ErhannisAutomated/s3_power_module/(list of files, drawings)

Other design files:
power_module_planes.dsn
