ErhannisAutomated/s3_power_module/power_module.kicad_pcb

## KiCad design power_module.kicad_pcb (2026-06-16)

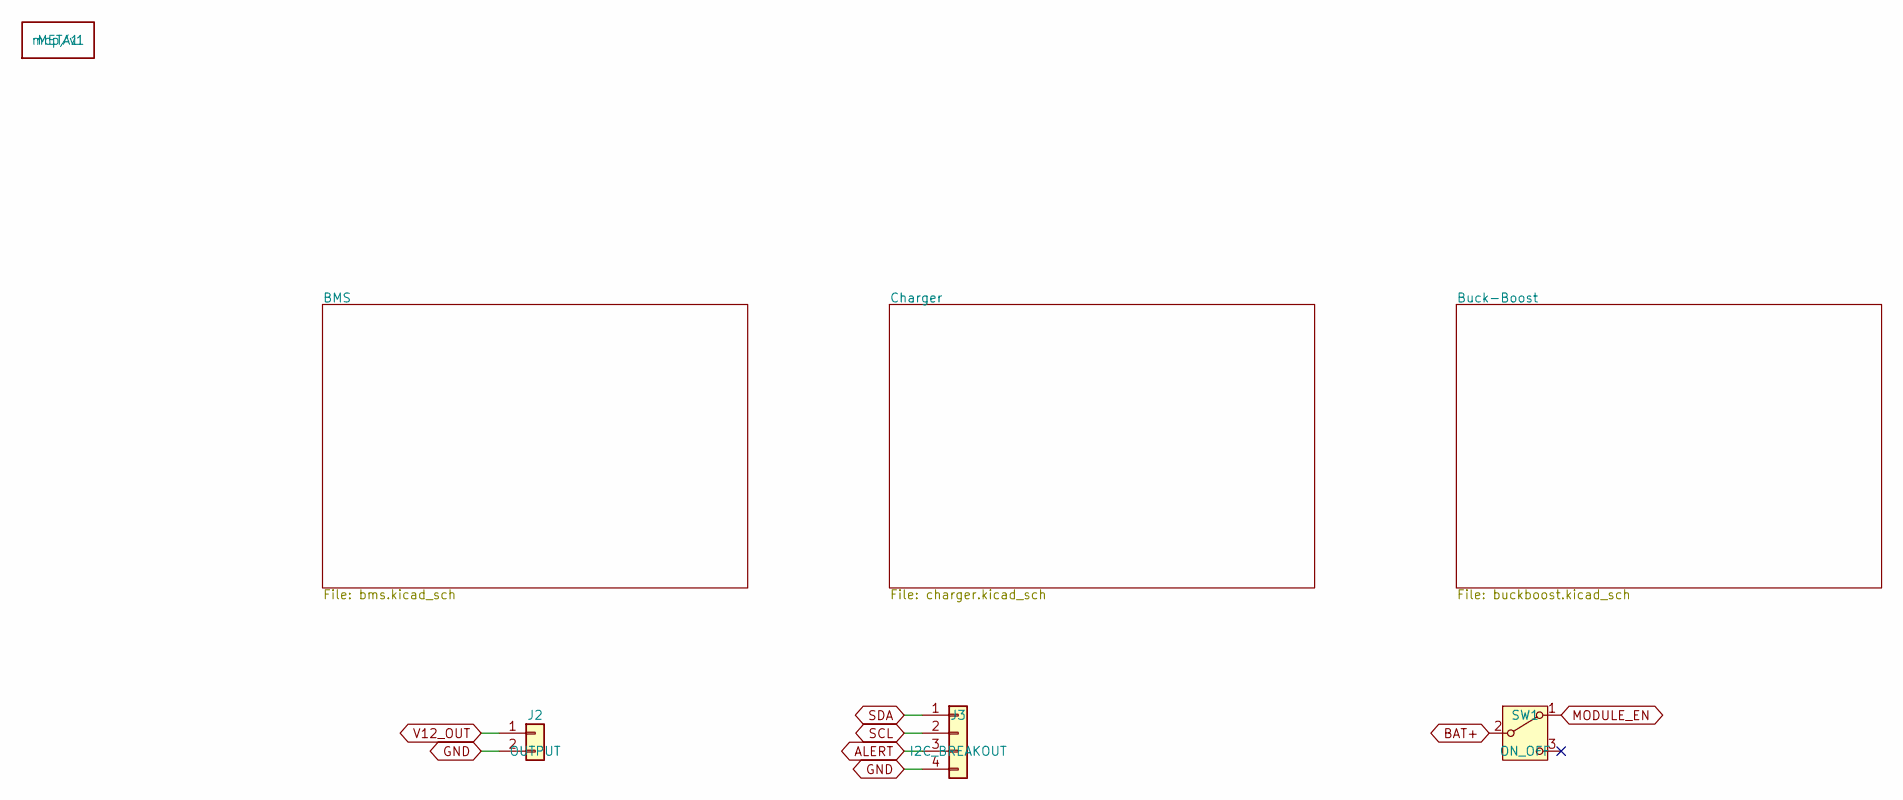
[picture p1: schematic power_module.kicad_sch]

Parts:
J2: OUTPUT; PinHeader_1x02_P2.54mm_Vertical
J3: I2C_BREAKOUT; PinHeader_1x04_P2.54mm_Vertical
META1: mcp/v1
SW1: ON_OFF; SW_SPDT_PCM12

Connections:
ALERT: J3.3; also elsewhere on the board
BAT+: SW1.2 (B); also elsewhere on the board
GND: J2.2, J3.4; also elsewhere on the board
MODULE_EN: SW1.1 (A); also elsewhere on the board
SCL: J3.2; also elsewhere on the board
SDA: J3.1; also elsewhere on the board
V12_OUT: J2.1; also elsewhere on the board

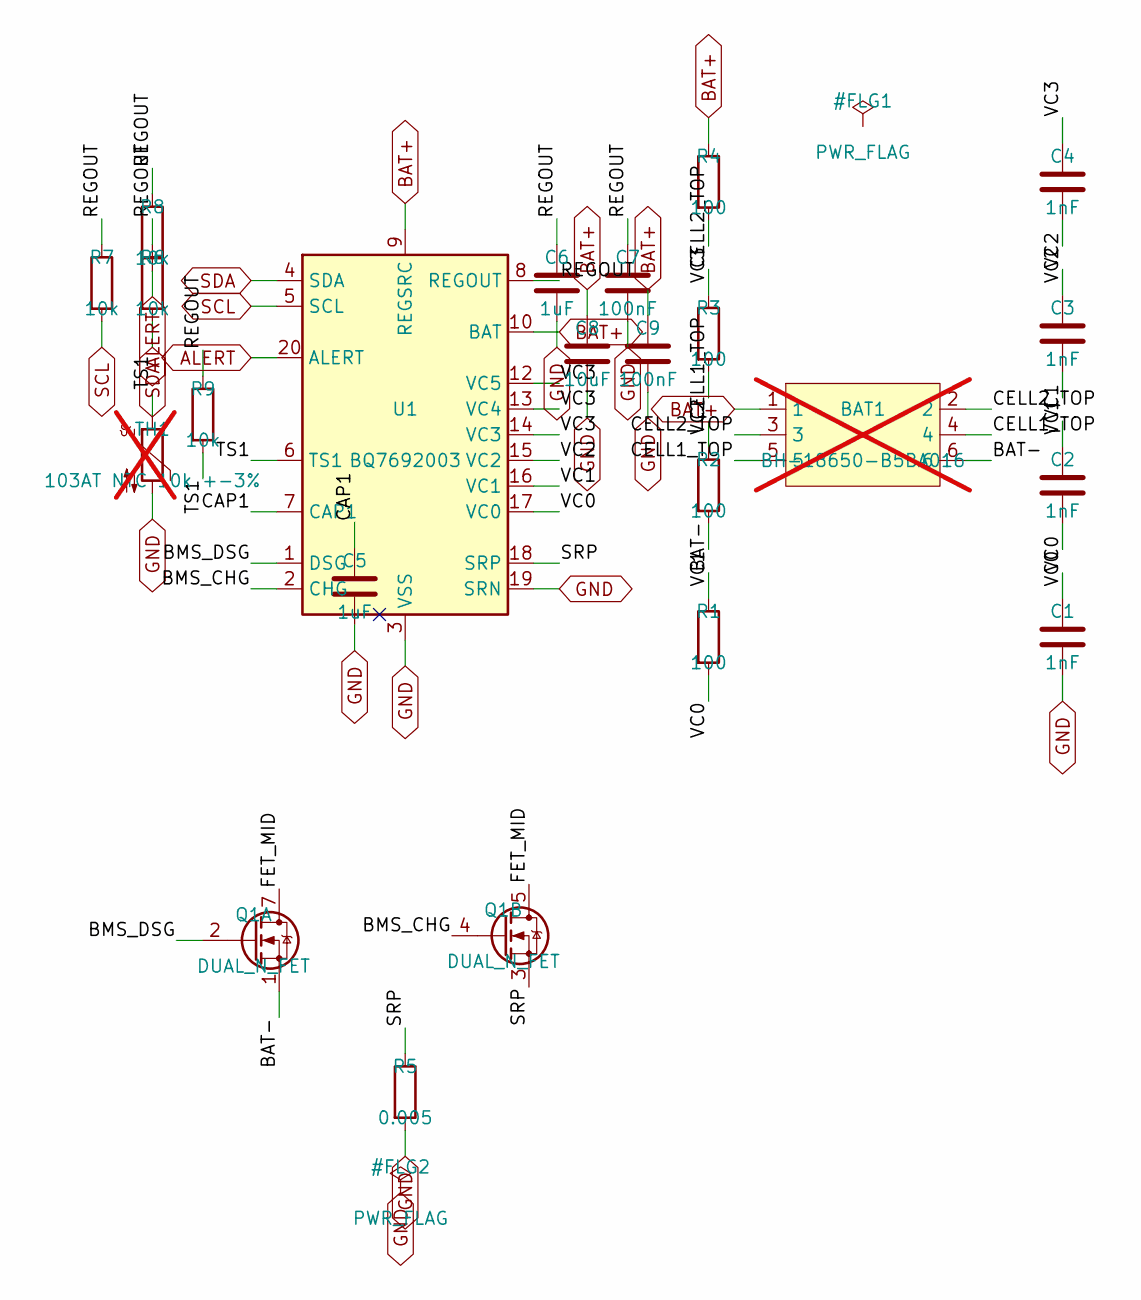
[picture p2: schematic bms.kicad_sch]

Parts:
BAT1: BH-18650-B5BA016; BAT-SMD_BH-18650-B5BA016; LCSC C19184086; not fitted
C1, C2, C3, C4: 1nF; C_0603_1608Metric; LCSC C1588
C5, C6: 1uF; C_0805_2012Metric; LCSC C28323
C7, C9: 100nF; C_0603_1608Metric; LCSC C14663
C8: 10uF; C_0805_2012Metric; LCSC C15850
Q1: DUAL_N_FET; SOIC-8_3.9x4.9mm_P1.27mm; LCSC C353066
R1, R2, R3, R4: 100; R_0603_1608Metric; LCSC C22775
R5: 0.005; R_1206_3216Metric; LCSC C2988648
R6, R7, R8, R9: 10k; R_0603_1608Metric; LCSC C25804
TH1: 103AT NTC 10k +-3%; R_Axial_DIN0204_L3.6mm_D1.6mm_P1.90mm_Vertical; not fitted
U1: BQ7692003; TSSOP-20_4.4x6.5mm_P0.65mm; LCSC C601650

Connections:
ALERT: R8.2, U1.20 (ALERT); also elsewhere on the board
BAT+: BAT1.1, C8.1, C9.1, R4.1, U1.9 (REGSRC), U1.10 (BAT); also elsewhere on the board
BAT-: BAT1.6, Q1.1 (S1), R1.1
BMS_CHG: Q1.4 (G2), U1.2 (CHG)
BMS_DSG: Q1.2 (G1), U1.1 (DSG)
CAP1: C5.1, U1.7 (CAP1)
CELL1_TOP: BAT1.4, BAT1.5, R2.1
CELL2_TOP: BAT1.2, BAT1.3, R3.1
FET_MID: Q1.5 (D2), Q1.6 (D2), Q1.7 (D1), Q1.8 (D1)
GND: C1.2, C5.2, C6.2, C7.2, C8.2, C9.2, R5.2, TH1.2, U1.3 (VSS), U1.19 (SRN); also elsewhere on the board
REGOUT: C6.1, C7.1, R6.1, R7.1, R8.1, R9.1, U1.8 (REGOUT)
SCL: R7.2, U1.5 (SCL); also elsewhere on the board
SDA: R6.2, U1.4 (SDA); also elsewhere on the board
SRP: Q1.3 (S2), R5.1, U1.18 (SRP)
TS1: R9.2, TH1.1, U1.6 (TS1)
VC0: C1.1, C2.2, R1.2, U1.17 (VC0)
VC1: C2.1, C3.2, R2.2, U1.16 (VC1)
VC2: C3.1, C4.2, R3.2, U1.15 (VC2)
VC3: C4.1, R4.2, U1.12 (VC5), U1.13 (VC4), U1.14 (VC3)

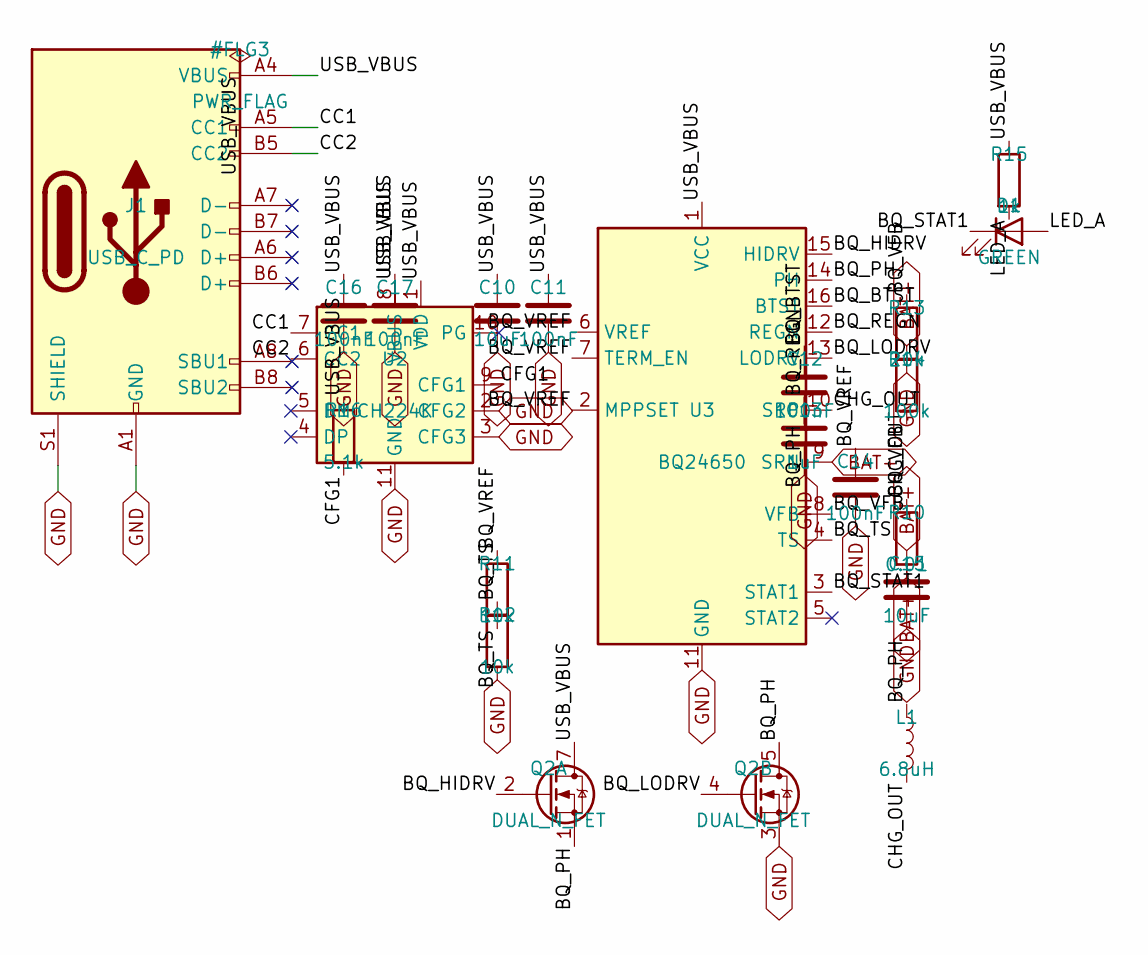
[picture p3: schematic charger.kicad_sch]

Parts:
C10, C15: 10uF; C_0805_2012Metric; LCSC C15850
C11, C12, C14, C16, C17: 100nF; C_0603_1608Metric; LCSC C14663
C13: 1uF; C_0805_2012Metric; LCSC C28323
D1: GREEN; LED_0805_2012Metric; LCSC C2297
J1: USB_C_PD; USB_C_Receptacle_HRO_TYPE-C-31-M-12; LCSC C165948
L1: 6.8uH; IND-SMD_L7.0-W6.6; LCSC C167221
Q2: DUAL_N_FET; SOIC-8_3.9x4.9mm_P1.27mm; LCSC C353066
R10: 0.01; R_1206_3216Metric; LCSC C601097
R11, R12: 10k; R_0603_1608Metric; LCSC C25804
R13: 20k; R_0603_1608Metric; LCSC C4184
R14: 100k; R_0603_1608Metric; LCSC C25803
R15: 1k; R_0603_1608Metric; LCSC C21190
R16: 5.1k; R_0603_1608Metric; LCSC C23186
U2: CH224K; MSOP-10_3x3mm_P0.5mm; LCSC C970725
U3: BQ24650; QFN-16-1EP_3x3mm_P0.5mm_EP1.7x1.7mm; LCSC C53712

Connections:
BAT+: C15.1, R10.2, R14.1, U3.9 (SRN); also elsewhere on the board
BQ_BTST: C12.1, U3.16 (BTST)
BQ_HIDRV: Q2.2 (G1), U3.15 (HIDRV)
BQ_LODRV: Q2.4 (G2), U3.13 (LODRV)
BQ_PH: C12.2, L1.1, Q2.1 (S1), Q2.5 (D2), Q2.6 (D2), U3.14 (PH)
BQ_REGN: C13.1, U3.12 (REGN)
BQ_STAT1: D1.1 (K), U3.3 (STAT1)
BQ_TS: R11.2, R12.1, U3.4 (TS)
BQ_VFB: R13.1, R14.2, U3.8 (VFB)
BQ_VREF: C14.1, R11.1, U3.2 (MPPSET), U3.6 (VREF), U3.7 (TERM_EN)
CC1: J1.A5 (CC1), U2.7 (CC1)
CC2: J1.A8 (SBU1), J1.B5 (CC2), U2.6 (CC2)
CFG1: R16.2, U2.9 (CFG1)
CHG_OUT: L1.2, R10.1, U3.10 (SRP)
GND: C10.2, C11.2, C13.2, C14.2, C15.2, C16.2, C17.2, J1.A1 (GND), J1.A12 (GND), J1.B1 (GND), J1.B12 (GND), J1.S1 (SHIELD), Q2.3 (S2), R12.2, R13.2, U2.2 (CFG2), U2.3 (CFG3), U2.11 (GND), U3.11 (GND), U3.17 (GND); also elsewhere on the board
LED_A: D1.2 (A), R15.2
USB_VBUS: C10.1, C11.1, C16.1, C17.1, J1.A4 (VBUS), J1.A9 (VBUS), J1.B4 (VBUS), J1.B9 (VBUS), Q2.7 (D1), Q2.8 (D1), R15.1, R16.1, U2.1 (VDD), U2.8 (VBUS), U3.1 (VCC)

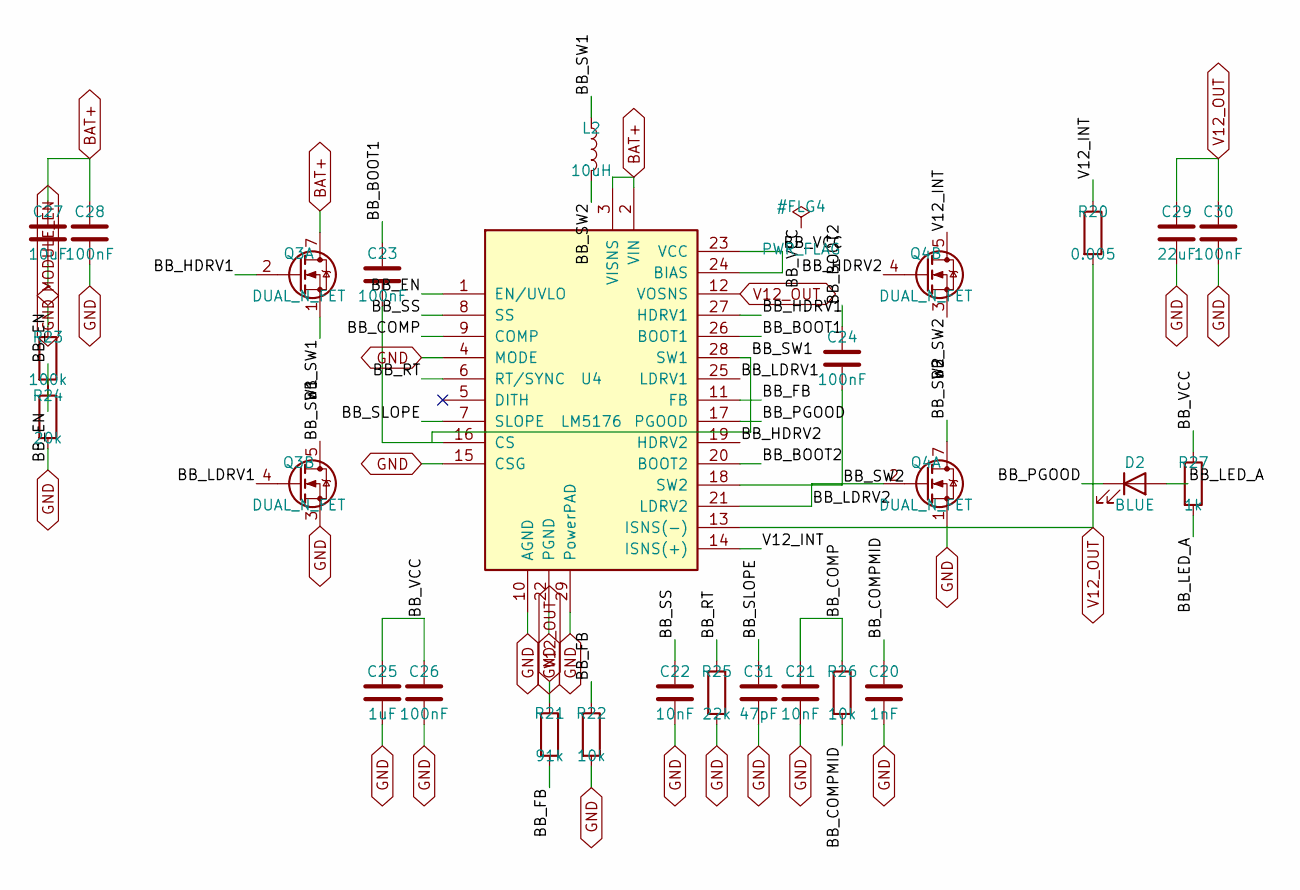
[picture p4: schematic buckboost.kicad_sch]

Parts:
C20: 1nF; C_0603_1608Metric; LCSC C1588
C21, C22: 10nF; C_0603_1608Metric; LCSC C57112
C23, C24, C26, C28, C30: 100nF; C_0603_1608Metric; LCSC C14663
C25: 1uF; C_0805_2012Metric; LCSC C28323
C27: 10uF; C_0805_2012Metric; LCSC C15850
C29: 22uF; C_1206_3216Metric; LCSC C12891
C31: 47pF; C_0603_1608Metric; LCSC C1671
D2: BLUE; LED_0805_2012Metric; LCSC C84259
L2: 10uH; IND-SMD_L7.1-W6.6; LCSC C41407100
Q3, Q4: DUAL_N_FET; SOIC-8_3.9x4.9mm_P1.27mm; LCSC C353066
R20: 0.005; R_1206_3216Metric; LCSC C2988648
R21: 91k; R_0603_1608Metric; LCSC C2907077
R22, R26: 10k; R_0603_1608Metric; LCSC C25804
R23: 100k; R_0603_1608Metric; LCSC C25803
R24: 20k; R_0603_1608Metric; LCSC C4184
R25: 22k; R_0603_1608Metric; LCSC C31850
R27: 1k; R_0603_1608Metric; LCSC C21190
U4: LM5176; HTSSOP-28-1EP_4.4x9.7mm_P0.65mm_EP2.85x5.4mm_ThermalVias; LCSC C442493

Connections:
BAT+: C27.1, C28.1, Q3.7 (D1), Q3.8 (D1), U4.2 (VIN), U4.3 (VISNS); also elsewhere on the board
BB_BOOT1: C23.1, U4.26 (BOOT1)
BB_BOOT2: C24.1, U4.20 (BOOT2)
BB_COMP: C21.1, R26.1, U4.9 (COMP)
BB_COMPMID: C20.1, R26.2
BB_EN: R23.2, R24.1, U4.1 (EN/UVLO)
BB_FB: R21.2, R22.1, U4.11 (FB)
BB_HDRV1: Q3.2 (G1), U4.27 (HDRV1)
BB_HDRV2: Q4.4 (G2), U4.19 (HDRV2)
BB_LDRV1: Q3.4 (G2), U4.25 (LDRV1)
BB_LDRV2: Q4.2 (G1), U4.21 (LDRV2)
BB_LED_A: D2.2 (A), R27.2
BB_PGOOD: D2.1 (K), U4.17 (PGOOD)
BB_RT: R25.1, U4.6 (RT/SYNC)
BB_SLOPE: C31.1, U4.7 (SLOPE)
BB_SS: C22.1, U4.8 (SS)
BB_SW2: C24.2, L2.2, Q4.3 (S2), Q4.7 (D1), Q4.8 (D1), U4.18 (SW2)
BB_VCC: C25.1, C26.1, R27.1, U4.23 (VCC), U4.24 (BIAS)
GND: C20.2, C21.2, C22.2, C25.2, C26.2, C27.2, C28.2, C29.2, C30.2, C31.2, Q3.3 (S2), Q4.1 (S1), R22.2, R24.2, R25.2, U4.4 (MODE), U4.10 (AGND), U4.15 (CSG), U4.22 (PGND), U4.29 (PowerPAD); also elsewhere on the board
MODULE_EN: R23.1; also elsewhere on the board
V12_INT: Q4.5 (D2), Q4.6 (D2), R20.1, U4.14 (ISNS(+))
V12_OUT: C29.1, C30.1, R20.2, R21.1, U4.12 (VOSNS), U4.13 (ISNS(-)); also elsewhere on the board

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
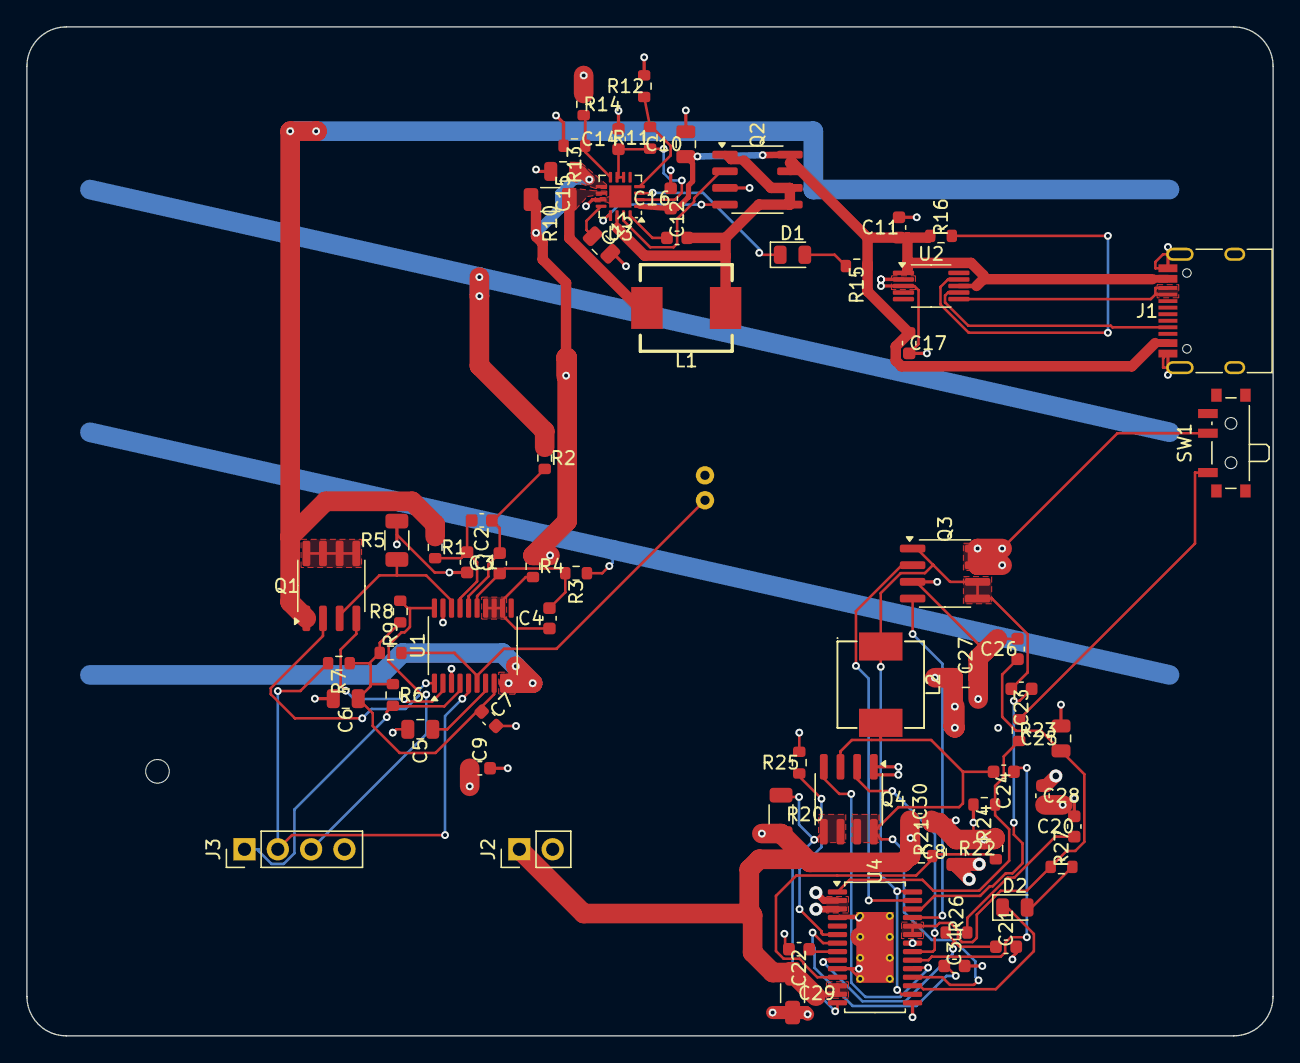
[picture p5: board power_module.kicad_pcb from above]

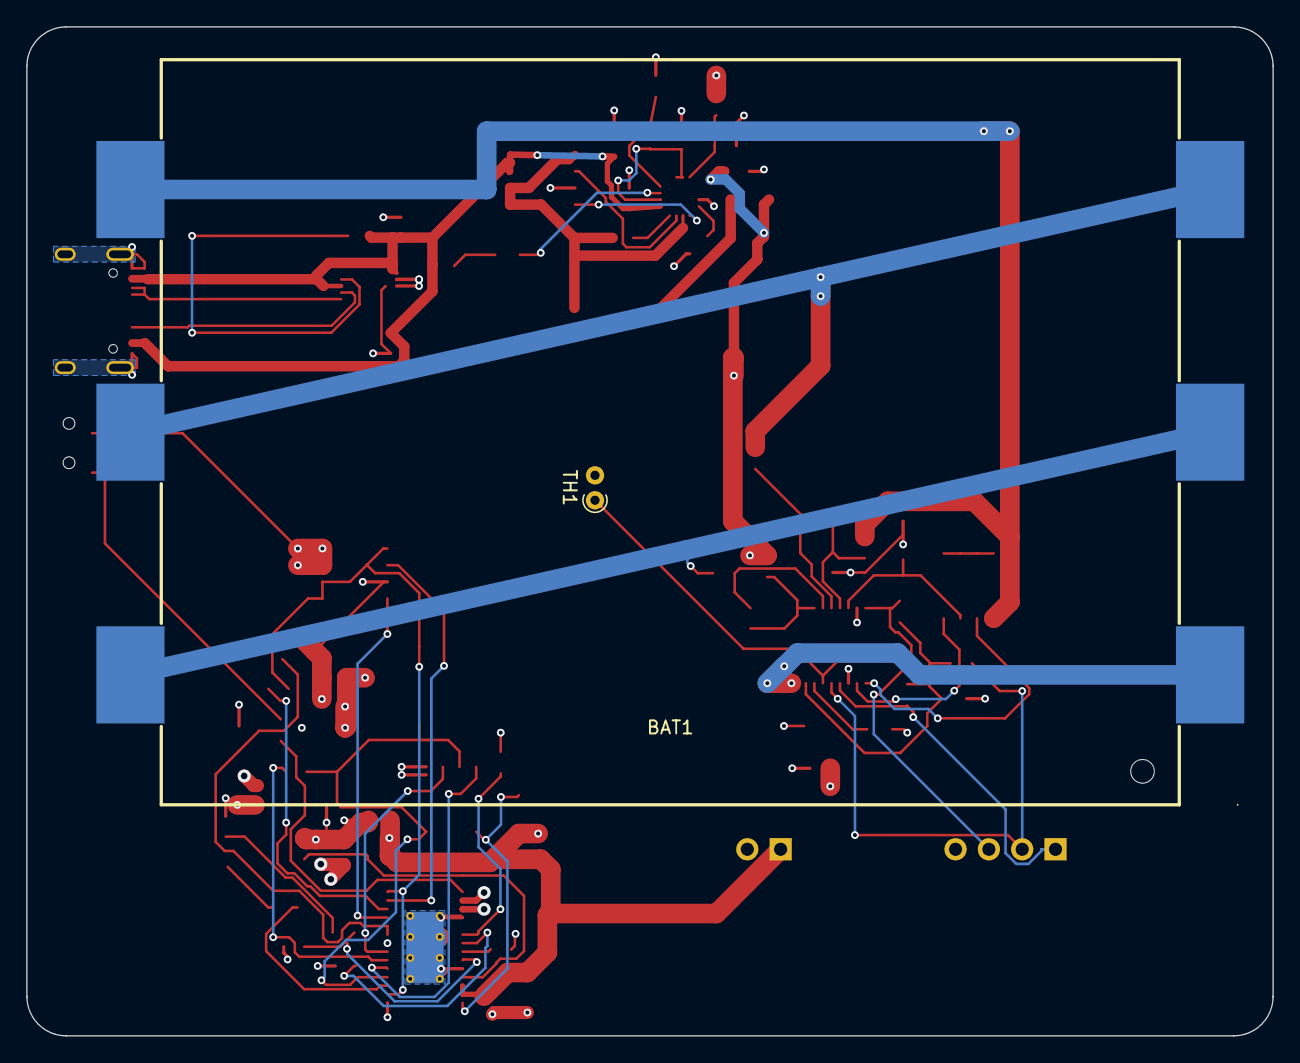
[picture p6: board power_module.kicad_pcb from below]

Board: 4 copper layers, 95.0 x 76.9 mm, 71 parts (2 on the bottom side), 55 nets.
