ErhannisAutomated/s3_power_module/(commit log)

2026-05-08 init: project spec for 3S 18650 12V power module
    Captures the original design prompt + later clarifications (cell holder
    choice C19184086, open decisions still to confirm). The schematic and
    PCB will be added in subsequent commits as the design progresses.
2026-05-08 spec: lock topology + switch placement decisions
    Walked back an earlier (mistaken) suggestion to put a high-side MOSFET
    on the 12 V output for user on/off. The user pointed out their
    original design had the protection FETs in series with battery
    negative — that's the canonical BMS architecture and the right
    placement. Reusing those CHG/DSG protection FETs for the user
    on/off switch (via the BMS shutdown pin) avoids a redundant output
    FET and drops quiescent current in OFF state to BMS sleep current.
    Locked decisions:
    - 4-switch buck-boost regulator for the 12 V output (handles full
    9-12.6 V battery range)
    - Single pair of CHG/DSG N-channel FETs in series with battery
    negativ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
2026-05-08 spec: lock major IC picks (CH224K, BQ25700A, BQ7692003, LM5176, dual N-FET C353066)
    Verified each in JLC's catalog with stock levels. Picks favour high
    stock + reasonable price + JLC SMT-friendly packages. All Extended
    parts ($3 setup fee per unique part), so 5 unique ICs ≈ $15 setup;
    acceptable for a one-off prototype.
    Topology summary:
    USB-C → CH224K (PD sink, requests 15-20 V) → BQ25700A charger →
    3S 18650 in C19184086 holder → BQ7692003 BMS with CHG/DSG FETs at
    battery negative → LM5176 4-switch buck-boost → 12 V / 4 A out
    C353066 dual-N-MOSFET (SOP-8, 30 V, 8 A, 26 mΩ, 1.5 V Vgs(th))
    covers both BMS protection FETs (2 needed) and LM5176 power FETs (4
    needed). R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
2026-05-08 spec: switch charger from BQ25700A to BQ24650RVAR
    BQ25700A had SMBus telemetry but is QFN-32 with no stock KiCAD symbol —
    ~hours of custom-symbol work to use it.
    BQ24650RVAR is simpler (VQFN-16), better stock (5,453 vs 3,224 units),
    covers the same use case (5-28 V input handles USB-C PD's 20 V; NMOS
    sync-buck supports up to 10 A so 4 A continuous is comfortable), and
    has a stock KiCAD symbol in Battery_Management.
    We don't lose I²C: the BQ76920 BMS already provides cell-level telemetry
    on I²C, which was the user's actual ask. Charger-level SMBus would
    have been redundant.
    All four major ICs (CH224K, BQ24650, BQ76920, LM5176) now have stock
    symbols — schematic can be built without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
2026-05-08 init: KiCAD project files (empty schematic + PCB)
    Created via mcp__kicad__create_project; subsequent commits will fill
    in the schematic and PCB.
    [power_module.kicad_pcb, power_module.kicad_sch]
2026-05-08 schematic: place BMS subcircuit components
    25 components placed (no wires yet) in the BMS subcircuit:
    U1 BQ7692003 BMS chip (TSSOP-20)
    BT1-3 three 18650 cells stacked at x=175
    R1-4 cell-tap resistors (100 Ω) for VC0..VC3
    C1-4 cell-tap RC-filter caps (1 nF)
    Q1 dual N-channel MOSFET (FDS9926A symbol; will swap value
    to C353066 in the LCSC pass) for CHG + DSG protection
    R5 0.005 Ω current-sense shunt
    C5 1 µF cap on CAP1 (cell-balance bootstrap)
    C6/C7 REGOUT bypass (1 µF + 100 nF)
    C8/C9 BAT decoupling (10 µF + 100 nF)
    R6-8 I²C SDA/SCL + ALERT pull-ups (10 kΩ)
    R9 NTC bias (10 kΩ)
    TH1 10 kΩ NTC thermistor on TS1
    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
    [power_module.kicad_sch]
2026-05-08 notes: session resume notes for next session
    Captures:
    - State at end of 2026-05-08 (BMS placed, no wires)
    - Ordered next-step list (wire BMS, then charger, then buck-boost,
    then integrate, then footprints/LCSC, then PCB)
    - BQ76920PW pin reference (so we don't have to re-extract from
    the .kicad_sym file)
    - Wiring intent for the BMS subcircuit
    - Q1 → C353066 substitution note (the FDS9926A symbol stands in
    for the part we'll specify in LCSC)
    - Cross-references to MCP-server open threads + memory files
    Intended to survive Claude Code context compaction by living in
    the project repo on disk.
2026-05-08 notes: record 4-layer stackup + ampacity-sized traces preferences for layout
    Both flagged by user this morning before resuming BMS wiring. Layer
    count and per-class trace widths haven't been tested through the MCP
    server yet; watch for issues during the eventual layout pass.
2026-05-08 schematic: wire BMS subcircuit (cell stack, taps, FETs, signals)
    All BMS-side connectivity in place via local net labels:
    - Cell stack: BAT+ / CELL2_TOP / CELL1_TOP / BAT-
    - Cell taps: VC0..VC3 with R1-R4 + RC caps C1-C4 (3S jumpers tie
    VC4=VC5=VC3 at the BMS pins, post-filter resistor)
    - Protection FETs Q1: dual N-FET in back-to-back (drains tied =
    FET_MID, sources to BAT- and SRP, gates to BMS_DSG/BMS_CHG).
    Added Q1 unit 2 (FDS9926A symbol is multi-unit; only unit 1 was
    placed previously).
    - Sense resistor R5: SRP at top, GND at bottom = U1.SRN = U1.VSS.
    - Support passives: REGOUT (C6/C7), BAT/REGSRC (C8/C9 on BAT+),
    CAP1 (C5).
    - Signals: SDA/SCL/ALERT pull-ups to REGOUT (R6/R7/R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
    [power_module.kicad_sch]
2026-05-08 schematic: add charger subcircuit (USB-C PD + BQ24650 sync buck)
    22 components placed and wired:
    - USB-C PowerOnly_24P receptacle (J1) → CH224K (U2) PD sink controller
    (configured for 20V request: CFG2/CFG3 to GND, CFG1 pulled to VDD via R16)
    - CH224K VBUS → BQ24650 (U3) input
    - BQ24650 sync buck: HIDRV/LODRV → Q2 dual N-FET (FDS9926A symbol;
    C353066 substitute at LCSC step), drains tied at PH/SW node, BTST
    bootstrap cap C12, REGN gate-drive cap C13, VREF bypass C14.
    - Inductor L1 (6.8 µH) between PH and inductor-output node.
    - Charger sense resistor R10 (10 mΩ) between SRP and BAT+ output;
    C15 output cap.
    - VFB divider R14/R13 (100k / 20k) sets 12.6V regulation
    (VFB = 2.1V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
    [power_module.kicad_sch]
2026-05-09 schematic: add 4-switch buck-boost output stage (LM5176)
    LM5176PWP HTSSOP-28 controller drives 2x dual N-FET pairs (Q3 input,
    Q4 output) through inductor L2 (10 µH). Topology:
    BAT+ → Q3a (HS_IN) → SW1 → L2 → SW2 → Q4b (HS_OUT) → V12_OUT
    ↓ ↓
    Q3b (LS_IN)→GND Q4a (LS_OUT)→GND
    + ISNS shunt R20 (5 mΩ) between Q4b drain and V12_OUT load.
    Regulation: VFB divider R21=90k / R22=10k → 12 V at FB=1.207 V.
    Soft-start C22=10 nF, RT/SYNC R25=22k (~440 kHz), Type II compensation
    C20/R26/C21 on COMP, slope cap C31=47 pF. Mode pin tied to GND for
    auto-PFM at light load.
    Power: input bulk + HF caps on BAT+ side (C27/C28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
    [power_module.kicad_sch]
2026-05-09 schematic: convert flat design into hierarchical sheets
    Split the single power_module.kicad_sch into a thin top-level that
    holds three sheet blocks (BMS, Charger, Buck-Boost) referencing
    sibling files bms.kicad_sch / charger.kicad_sch / buckboost.kicad_sch.
    Partition (via /tmp/claude/partition_sheets.py):
    - Components grouped by reference designator into BMS_REFS /
    CHARGER_REFS / BUCKBOOST_REFS buckets (28 / 23 / 28 symbols).
    - Wires kept by BFS from each kept symbol's pin world coords —
    grows the keep-set until no new wires can be reached.
    - Labels / junctions / no_connects kept when their position is
    on a kept-component pin OR a kept-wire endpoint.
    - Each child gets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
    [bms.kicad_sch, buckboost.kicad_sch, charger.kicad_sch, power_module.kicad_sch]
2026-05-09 schematic: integrate subcircuits — output, I²C, user switch
    Top-level power_module.kicad_sch gains the user-facing components:
    J2 Conn_01x02 output header : V12_OUT, GND
    J3 Conn_01x04 I²C breakout : SDA, SCL, ALERT, GND
    SW1 SW_SPDT user on/off switch : MODULE_EN ↔ BAT+ (pin 3 NC)
    For these to span sheets, V12_OUT (Buck-Boost) and SDA/SCL/ALERT (BMS)
    were promoted from local labels to global_label inside their child
    sheets (one Python pass over each .kicad_sch). KiCad joins
    global_labels by name across all sheets without sheet pins.
    User switch behaviour: SW1 routes BAT+ through to a new MODULE_EN
    global net. Inside buckboost.kicad_sch, R23.pin1 (t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
    [bms.kicad_sch, buckboost.kicad_sch, power_module.kicad_sch]
2026-05-09 schematic: re-orient existing labels to match their pin's outward angle
    One-shot pass over all four .kicad_sch files: for each label, find the
    nearest pin (directly coincident or via a 1-3 hop wire-graph walk
    from the label's anchor) and set the label's orientation to that
    pin's outward angle. Labels not near a pin (mid-wire stubs, dangling
    markers) are left alone.
    power_module: 7 of 8 labels updated
    bms: 61 of 71 labels updated
    charger: 52 of 69 labels updated
    buckboost: 60 of 74 labels updated
    The remaining ~15-20% of labels are either at orientations that were
    already non-zero (caller set explicitly) or at coordinates with no
    pin reachable within the search depth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
    [bms.kicad_sch, buckboost.kicad_sch, charger.kicad_sch, power_module.kicad_sch]
2026-05-09 schematic: repair child-sheet (instances …) paths after partition
    When the flat schematic was split into hierarchical sheets, every
    component carried its (instances (project … (path …))) block from the
    flat design — single-segment path /<flat_root_uuid> — into its new
    child .kicad_sch. KiCad's per-project annotation lookup expects the
    hierarchical path /<top_root_uuid>/<sheet_block_uuid>, so all
    components on child sheets rendered as Q?, R?, etc.
    Per-sheet repair (one-shot, /tmp/claude/repair_instance_paths.py):
    bms.kicad_sch: 27 paths updated
    charger.kicad_sch: 23 paths updated
    buckboost.kicad_sch: 28 paths updated
    Top-level path is computed from the parent fi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
    [bms.kicad_sch, buckboost.kicad_sch, charger.kicad_sch]
2026-05-09 notes: end-of-2026-05-09 session resume notes
    Schematic is complete and split into hierarchical sheets (top-level
    + bms/charger/buckboost children). Cross-sheet nets use global_label.
    Top-level ERC: 0 errors, 1 footprint warning.
    Today's session focused on MCP server improvements (autoplacer,
    sheets, renderer, label orientation, autorouter rule 6, orphan-chain
    fix, cache invalidation). See KiCAD-MCP-Server CHANGELOG for the
    full list.
    Tomorrow's natural starting points are documented in NOTES:
    1. Fix PinLocator multi-unit lookup so the autoplacer's rewire
    can use the autorouter again (instead of label-stubs).
    2. Tune the autoplacer force constants — current placements are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
2026-05-13 schematic: parts pass + cell-holder and USB-C symbol swaps
    - Apply Footprint + LCSC + Description to all 67 non-cell components
    across bms / charger / buckboost (JLCPCB-friendly BOM).
    - Add project-local power_module_lib (symbols + footprints fetched via
    easyeda2kicad for BH-18650-B5BA016 holder and the two custom-package
    inductors).
    - bms: replace BT1-3 (3x Battery_Cell) with single 6-pin BAT1 holder
    (BH-18650-B5BA016, C19184086). Pin mapping respects all-cells-same-
    direction; CELL1_TOP/CELL2_TOP taps repeat on inner pins.
    - charger: swap J1 from USB_C_Receptacle_PowerOnly_24P to
    USB_C_Receptacle_USB2.0_16P (matches HRO TYPE-C-31-M-12 16P
    footprint). NC the 6 unused USB 2.0 d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
    [bms.kicad_sch, buckboost.kicad_sch, charger.kicad_sch]
2026-05-13 pcb: 4-layer stackup, netclasses, partial sync checkpoint
    - Stackup expanded to 4 copper layers (F.Cu/In1.Cu/In2.Cu/B.Cu).
    Plan: In1.Cu = GND pour, In2.Cu = PWR pour.
    - Add POWER_4A (1.5 mm / 0.25 mm clearance, 1.0 mm via) and POWER_2A
    (0.8 mm / 0.2 mm clearance, 0.7 mm via) netclasses in
    power_module.kicad_pro net_settings, with patterns assigning BAT+,
    BAT-, V12_OUT to POWER_4A and USB_VBUS, CHG_OUT, BQ_PH to POWER_2A.
    Done via direct .kicad_pro edit because the MCP add_net_class and
    create_netclass tools are both broken.
    - First sync_schematic_to_board imported only the 3 top-level
    footprints (J2/J3/SW1); a server-side bug skipped the 67
    child-sheet components. Patched in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
    [power_module.kicad_pcb, power_module.kicad_sch]
2026-05-13 pcb: sync 71 footprints from schematic (full hierarchical import)
    After the MCP-server restart picked up the hierarchical-sync fix,
    re-syncing imported all 71 footprints (J2/J3/SW1 from the parent
    sheet plus the 67 child-sheet components plus BAT1 and J1, then U4
    manually after fixing its missing-footprint reference to the
    EP2.85x5.4mm_ThermalVias HTSSOP-28 variant). 256 pads have nets
    assigned.
    Footprints are sitting in an off-board grid above y=0; placement
    into the board area happens in the next step (#89 layout pass).
    Also: add .gitignore for *_erc.json artifacts.
    [buckboost.kicad_sch, power_module.kicad_pcb]
2026-05-13 pcb: first-pass placement for all 71 footprints
    Layout floorplan: 95x110 mm rounded rectangle. Cell holder (BAT1)
    across the top half centered at (47.5, 23). Bottom half partitioned
    into three column strips:
    - x = 0-30: BMS (U1, R1-9, C1-9, Q1, R5, TH1).
    - x = 30-60: charger (J1 region, U2, U3, Q2, L1, R10-16, D1, C10-17).
    - x = 60-95: buck-boost (U4, Q3-Q4, L2, D2, R20-27, C20-31).
    Edge connectors on the south edge: J3 (I2C 4-pin), J2 (12V output
    2-pin), SW1 (slide). USB-C J1 on the east edge.
    This is intentionally rough — autorouting and DRC will surface
    real overlaps and force iteration.
    [power_module.kicad_pcb]
2026-05-13 pcb: persist all 71 placement moves via direct file rewrite
    Workaround for the MCP server bug recorded in mcp_server_issues.md
    (commit b8183d8 in KiCAD-MCP-Server develop): move_component
    silently operated on a different in-memory BOARD than save_project
    wrote, so the first save in this layout pass landed the auto-import
    grid coords instead of the placement.
    Recovered the intended positions from get_component_list (which
    also reads the orphaned BOARD, hence consistent with the moves) and
    rewrote each footprint's (at X Y rot) line directly. Script kept
    at /tmp/claude/apply_positions.py. An MCP-server restart is needed
    before further PCB writes to pick up the fix and reset the diverged
    in-m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
    [power_module.kicad_pcb]
2026-05-13 pcb: rewrite (at) positions with corrected helper script
    apply_positions.py had an off-by-N bug: it advanced its byte cursor
    using the *post-substitution* block length rather than the original
    slice end, so any (at X Y rot) replacement that wrote fewer bytes
    than the source line left the cursor lagging. The next iteration
    then re-emitted the tail bytes of the previous footprint, injecting
    stray top-level ')' characters into the file (which manifested as
    pcbnew.LoadBoard returning only one footprint).
    Fix: track original_len separately from the in-place modified block
    length. Helper script committed at apply_positions.py for future
    recovery.
    [power_module.kicad_pcb]
2026-05-13 pcb: add GND (In1.Cu, B.Cu) and BAT+ (In2.Cu) copper pours
    4-layer stackup is now:
    L1 F.Cu — signal routing
    L2 In1.Cu — GND fill
    L3 In2.Cu — BAT+ fill (highest-current rail)
    L4 B.Cu — GND fill + signal routing
    [power_module.kicad_pcb]
2026-05-13 pcb: first-pass autoroute via Freerouting (8 passes, 64% routed)
    Imported 412 tracks + 74 vias. 184 nets in, 66 still unrouted after
    8 passes and 4 minor violations. Placement is too tight for a
    clean route — R/C cell-tap row at y=47-51 has courtyards overlapping
    and is the most likely contributor to the unrouted count. Saving as
    a checkpoint before iterating placement.
    Note: autoroute MCP wrapper has a 30s TS-side timeout but the
    underlying call needs minutes (run took ~8 minutes for 8 passes).
    Ran freerouting directly via Bash as a workaround.
    [power_module.dsn, power_module.kicad_pcb]
2026-05-13 pcb: iterate 1 — clean tracks, drop B.Cu pour, spread tap-row + R/Cs
    Iteration to reduce the unrouted count from freerouting v1 (66/184).
    Changes this pass:
    - Stripped 412 tracks + 74 vias from previous SES import for a
    clean re-route from the DSN.
    - Removed B.Cu GND copper pour (was occluding signal routing on
    L4; In1.Cu still has GND fill which is the planar return).
    - Stripped a stray empty F.SilkS zone the MCP kept regenerating.
    - Spread R1-4 + C1-4 cell-tap network: now 6mm pitch with cleaner
    separation; row pushed below the BAT1 courtyard edge to y=53/58.
    - Moved U2 (CH224K) left to (72, 47) so J1 USB-C at (88, 55) has
    room.
    - Repositioned R26, R27, C29 i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
    [power_module.kicad_pcb]
2026-05-13 pcb: autoroute v2 with B.Cu freed up — 379 tracks, 79 vias
    Slightly worse than v1 (412/74). Suggests the iteration changes
    (removed B.Cu GND, spread tap row, moved U2) didn't help the
    freerouting heuristic. 34 via_dangling errors in DRC indicate
    incomplete routing attempts.
    Also save: BOM csv export attempt (currently captures only the 3
    top-level parts because export_bom doesn't walk hierarchical sheets;
    fix queued in develop branch but needs MCP-server restart).
    [power_module.dsn, power_module.kicad_pcb, power_module_bom.csv]
2026-05-13 notes: 2026-05-13 PCB layout + autoroute session resume guide
2026-05-13 pcb: export BOM (32 lines, hierarchical fix loaded), gerber, pos
    BOM: 32 unique value+footprint lines covering 71 components; LCSC
    and Description columns populated (export_bom hierarchical-walk fix
    loaded after MCP restart).
    Gerber: 25 layer files + 2 drill (PTH/NPTH) + job file in gerber/.
    Includes both inner copper layers (g1=GND, g2=BAT+ planned but no
    pour landed — see notes).
    Position file: 71 placements; via kicad-cli because the
    export_position_file MCP tool is schema-exposed but unimplemented.
    #92 closes the planned PCB workflow. The board itself has open
    routing work (~36% unrouted across passes); design demo end-to-end
    is validated but the board is not production-ready.
    [power_module-B_Courtyard.gbr, power_module-B_Cu.gbl, power_module-B_Fab.gbr, power_module-B_Mask.gbs, power_module-B_Paste.gbp, power_module-B_Silkscreen.gbo, power_module-Edge_Cuts.gm1, power_module-F_Courtyard.gbr]
2026-05-13 pcb: repair In2.Cu layer corruption, add BAT+ inner pour
    Background: yesterday's add_layer call ran against the pre-fix MCP
    which mapped inner number=2 to id 5 (F.Silkscreen) instead of id 6
    (In2.Cu). The board file ended up with layer 5 named "In2.Cu" and
    no real BAT+ pour anywhere. The MCP fix (KiCAD-MCP-Server commit
    6d438de) prevents this for new boards but doesn't repair existing
    corruption.
    This commit:
    - Restores layer 5's name to "F.Silkscreen" so GetLayerID("In2.Cu")
    unambiguously resolves to 6.
    - Adds a BAT+ copper pour on In2.Cu mirroring the existing GND
    pour on In1.Cu (clearance 0.25mm, priority 0).
    - Refills both zones.
    PCB is now a real 4-layer GND/PWR sandwi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
    [power_module.kicad_pcb]
2026-05-13 pcb: re-route v3 with In2.Cu BAT+ pour — major BAT+ improvement
    After the MCP add_layer fix and the In2.Cu BAT+ pour was added, ripped
    up all tracks/vias and ran a fresh 25-pass freerouting.
    Per-net comparison (v2 -> v3) on the big power nets:
    BAT+: F.Cu 218.5mm / 38 segs / 0 vias -> F.Cu 15.9mm / 10 segs / 9 vias
    GND: already-pour-routed -> F.Cu 39.7mm / 53 segs / 34 vias
    BAT+ is now mostly carried on the In2.Cu BAT+ pour with short F.Cu stubs
    to stitching vias. GND likewise drops to short stubs to the In1.Cu
    GND pour. Final track/via count: 367 tracks + 76 vias. Freerouting's
    final score 833.03 (vs 1100+ in v2).
    Remaining 4 violations + ~18 unrouted ratlines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
    [power_module.kicad_pcb, power_module_planes.dsn]
2026-05-14 pcb: fix stale pad rotations on all 57 rotated footprints
    Background: yesterday's `apply_positions.py` recovered footprint
    positions after the place_component dispatch bug. It directly
    rewrote the `(at X Y rot)` line on each footprint via regex, but
    did NOT touch the per-pad local rotation fields.
    KiCad's renderer + pcbnew API combine footprint_rot for the pad's
    WORLD POSITION (centre coordinate) but use only the pad's LOCAL
    rotation for the pad SHAPE orientation. Net result: every pad on
    every rotated footprint was drawn at the right centre but with the
    wrong orientation — long axis pointed the original library
    direction. On J1 (USB-C 16P) all 16 SMD pads stacked vertically
    on top of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
    [power_module.kicad_pcb]
2026-05-14 pcb: J1 inward, J2/J3 horizontal, BAT1 to back + DNP
    User feedback after the pad-rotation fix:
    - J1 was rotated -90° with pins facing the right (board edge) so the
    USB-C receptacle opening faced inward; correct orientation is
    +90° (pins inward, opening to edge). Net rotation change: +180°.
    - J2 and J3 are 1x02 / 1x04 pin headers placed at y=103 mm on a
    110 mm tall board. Vertical-pin-row footprints meant the pin
    columns ran along Y and the last pin of J3 ended up at y≈110.6,
    just past the board edge. Rotated each by +90° so the pin row
    runs along X.
    - BAT1 (the 3S 18650 holder) moved to the back layer and marked
    do-not-populate. The user already h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
    [power_module.kicad_pcb]
2026-05-14 pcb: re-route v4 with correct pad orientations — 593 tracks routed
    After the pad-rotation repair, freerouting can finally see real pad
    shapes instead of stacked-pad blobs.
    Results vs v3 (stacked pads):
    tracks: 367 -> 593 (+62%)
    vias: 76 -> 112 (+47%)
    time: 13:52 -> 3:20 (4x faster — fewer pad-shape misses to retry)
    unrouted ratlines: 18 -> 21 (essentially equivalent)
    violations: 4 -> 0 (no router-side violations)
    Per-layer routing distribution:
    F.Cu 474 tracks, 947 mm (signal + BAT+/GND stubs)
    In1.Cu 53 tracks, 481 mm (GND pour)
    In2.Cu 48 tracks, 440 mm (BAT+ pour)
    B.Cu 18 tracks, 36 mm (signal)
    Remaining DRC issues (130 violations)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
    [power_module.dsn, power_module.kicad_pcb]
2026-05-14 pcb: re-route v6 — C24 nudged out of L2 footprint; zero shorts
    Yesterday's apply_positions.py placed C24 (0603 bootstrap cap) at
    (62, 80), which falls inside L2's footprint bbox (61-69, 76.6-83.4
    mm). v4's three shorting_items DRC errors all originated here.
    Moved C24 to (58.5, 80) — into the 5 mm clear gap between C15
    (right edge 56.01) and L2 (left edge 61.02). ~3.5 mm extra trace
    length to the BB_BOOT2 / BB_SW2 nets is acceptable for a 100 nF
    bootstrap cap.
    Routed via freerouting -mp 25 in 2:54. Result:
    tracks: 616 (was 593)
    vias: 117 (was 112)
    unrouted ratlines: 20 (was 21)
    shorting_items: 0 ← fixed
    solder_mask_bridge: 0 ← fixed
    Remaining 13 clearance violatio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
    [power_module.dsn, power_module.kicad_pcb]
2026-05-14 notes: 2026-05-14 afternoon session — pad rotation + v6 re-route
    Documents the pad-rotation root cause (user's visual catch), the
    57-footprint repair, the J1/J2/J3 + BAT1 layout corrections, and
    the v6 routing result (616 tracks, 0 shorts). Plus the MCP
    `self.board` cache gotcha that bit us during the C24 nudge.
2026-05-15 pcb: re-route v7 — 20 unrouted ratlines down to 4, zero DRC errors
    Loosened netclass clearances (Default/POWER_2A 0.2->0.13mm, POWER_4A
    0.25->0.15mm) so freerouting can escape the fine-pitch CH224K MSOP-10
    and BQ24650 QFN-16 pads — this was the dominant fix. Also fixed 6
    courtyard overlaps, repositioned BAT1 so J1's shield pad no longer
    shorts to it (and converted BAT1's mounting hole PTH->NPTH), and
    relaxed min_resolved_spokes 2->1 for the U4 thermal EP.
    Hand-routed BAT+ at U4, the USB_VBUS A4/B4 jumper under J1, and GND
    at U4-15. Remaining 4 unrouted: BQ_PH/CHG_OUT (U3 QFN 0.5mm pitch
    blocks a via escape) and BAT+/GND near U1/U4 (inner planes fragmented
    by signal routing).
    Co-Authore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
    [power_module.kicad_pcb]
2026-05-15 pcb: add redundant via per BAT1 cell-terminal pad
    Doubles via count on the high-current battery paths (BAT+, BAT-, the
    two CELL_TOP nets). Each ≤0.5 mm-drill via is rated ~1.5-2 A;
    two-in-parallel comfortably covers the 4 A design current with margin.
    Vias placed via-in-pad at (pad_x, pad_y + 2 mm), well inside the
    5.2 × 7.4 mm SMD pad — safe given BAT1 is DNP / hand-mount.
    [power_module.kicad_pcb]
2026-05-15 pcb: re-route v10 with GND-last layer priority — 912mm -> 453mm plane cuts
    Stripped tracks and re-routed via freerouting with the DSN layer order
    swapped from [F.Cu, In1.Cu, In2.Cu, B.Cu] (the as-exported default,
    which biases freerouting toward inner layers) to
    [F.Cu, B.Cu, In2.Cu, In1.Cu] — outer layers first, then PWR, then GND
    last so the closest-plane image-current return path stays intact.
    Headline:
    F.Cu segments: 632 -> 581
    B.Cu segments: 23 -> 75 (3.3x) <- moved off the planes
    In1.Cu (GND): 88 -> 53
    In2.Cu (PWR): 46 -> 19
    Plane cuts: 912mm -> 453mm (50% reduction, audit_plane_cuts)
    Routed: 4 unrouted -> 6 unrouted (BAT+ U4, BQ_PH, CHG_OUT, USB_VBUS
    jumper, BQ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
    [power_module.kicad_pcb]
2026-05-15 pcb: v11c — autoroute(GND-last default) + BAT1 fork-multi-via fix
    Stripped + autorouted with no explicit layerOrder — the new MCP
    default [F.Cu, B.Cu, In2.Cu, In1.Cu] applied automatically (verified
    in the autoroute return). 50% plane-cut reduction preserved from v10
    but the layer balance further shifted toward PWR-cut-not-GND: In1.Cu
    (GND) cut length is now ~68mm vs v10's ~190mm.
    Applied the fork-multi-via pattern on all 6 BAT1 cell-terminal pads:
    two through vias inside each pad bridged by a 1.5mm POWER_4A trace
    on In1.Cu — the pad itself is the "bubble", current splits across
    both vias, and the existing freerouting-placed In1.Cu signal becomes
    the one trace leading out. The BAT- vi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
    [power_module.kicad_pcb]
2026-05-15 notes: 2026-05-15 session wrap-up + tomorrow's resume guide
    Captures v11c state (GND-last autoroute default + BAT1 fork-multi-via),
    the 5 residual unconnected nets, the layer-cut audit numbers, every
    develop-branch MCP commit shipped today, and the agreed next-session
    target (decoupling-audit + place_near tools per the
    [[feedback-placement-constraints-design]] memory).
    Also un-tracks the regenerated power_module.dsn/.ses freerouting
    intermediates — autoroute rewrites them every run, so they don't
    belong in git. The historical *_planes.dsn/.ses experiment files
    stay tracked.
    [power_module.dsn]
2026-05-15 power_module: Placement_Anchor on C9, mcp_constraint_version=1
    First use of the new placement-constraint v1 tooling. C9 (100 nF
    decoupling for U1's BAT pin) now carries
    `Placement_Anchor = "U1.9/within=3mm"` on bms.kicad_sch — the
    audit/place_near tools honor this as an explicit anchor.
    PCB position unchanged this commit; the actual move + reroute is a
    follow-up (`place_near` works but stripped C9's BAT+/GND routing,
    took DRC from 0→5 errors — see NOTES.md for the dance to do it
    cleanly).
    [bms.kicad_sch]
2026-05-16 pcb: fix R26/R27 pad rotation drift (cosmetic, surfaced by integrity check)
    R26/R27 had pad local rotation 270 deg while their footprint rotation
    was 0 — remnant of the 2026-05-14 apply_positions.py incident that
    rewrote footprint rotations without propagating to pads. R12 (same
    lib_id) is the reference (pad_rot matches fp_rot).
    Electrically benign for symmetric 0603 resistor pads, but flagged by
    the new MCP `check_pcb_integrity` tool as `pad_rotation_mismatch`
    (uniform-drift warning).
    Fix: set pad orientation = footprint orientation for both pads on
    each affected footprint. 4-line .kicad_pcb diff.
    Before: 5 integrity findings (2 warning pad_rotation + 3 warning
    courtyard_overlap). Afte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
    [power_module.kicad_pcb]
2026-05-16 notes: 2026-05-16 session 2 — DRC filters + integrity check work
    Captures the second batch of MCP tooling from today (get_drc_violations
    filters + check_pcb_integrity) and the integrity audit results on
    current v11c: 0 errors, 3 courtyard_overlap warnings (R10/L1, L2/C25,
    R25/J1) — placement issues worth a look but not show-stoppers.
    Next-session candidates list refined: BAT1 routing fix promoted to #1
    (user deferred earlier today; want to come back to it).
2026-05-16 pcb: decoupling-cap placement pass via place_near (12 caps moved)
    Moved 12 of 13 too_far primary decoupling caps near their IC power
    pins using place_near. C6 (5.155 mm from U1.8) left alone -- already
    close enough to gain little.
    Highlights:
    C9 18.480 -> 3.242 mm (U1.9 BAT+, explicit max=3)
    C15 19.519 -> 5.075 mm (U4.2 BAT+)
    C10 16.712 -> 7.103 mm (U3.1 USB_VBUS, congested area)
    C25 16.539 -> 4.122 mm (U4.23 BB_VCC)
    C26 13.981 -> 3.242 mm
    C11 13.801 -> 6.294 mm
    C17 12.861 -> 2.571 mm
    C28 12.713 -> 2.361 mm
    C27 11.275 -> 4.361 mm
    C16 11.373 -> 4.236 mm
    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
    [power_module.kicad_pcb]
2026-05-16 pcb: rip dangling + autoroute moved cap nets
    After placing the decoupling caps (22e01fd), 21 dangling track
    segments and 4 orphan vias were left at the caps' old positions.
    Iteratively ripped dangling tracks/vias until stable, then ran
    freerouting on the whole board (it left existing good routes alone
    and re-routed the unrouted cap connections).
    Autoroute introduced 24 zone-clearance + hole-clearance errors
    (vias placed without anti-pads in the inner GND and BAT+ planes) and
    3 annular-width errors (freerouting used 0.5 mm drill for 0.6 mm pad
    on BAT+/BAT- vias near the battery cells). Refill_zones resolved all
    zone-clearance issues; setting those 3 vias to the project default
    0.3 mm drill r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
    [power_module.kicad_pcb]
2026-05-16 notes: 2026-05-17 session -- decoupling-cap placement pass
    Documents MCP commits (40aeaa1 audit perf, e9fcbd2 + f4c5d03
    place_near safety + run_drc auto-save), the placement work on
    power_module (22e01fd + 4b13380), final DRC state, and next-session
    candidates (4 remaining cap unconnects, then BAT1 reroute).
2026-05-16 pcb: close 3 of 4 cap unconnects (C28 BAT+, C7 REGOUT, C11 USB_VBUS)
    C28.1 BAT+: route_pad_to_pad to C27.1 on F.Cu, width 0.4 mm (1.5 mm
    shorted to C15.2 GND at 1.43 mm clearance).
    C7.1 REGOUT: 3-segment waypoint around U1's east edge — east to
    X=16.85 (avoids GND via at 16.29 with 0.16 mm clearance), south, west
    into C7.1.
    C11.1 USB_VBUS: 3-segment waypoint around C11.2 GND south — direct
    diagonal hit 0.031 mm clearance.
    C26.1 BB_VCC deferred: F.Cu blocked by BB_HDRV1/LDRV1 stubs on the
    U4 pad row, B.Cu blocked by BB_BOOT2 spanning X=57.9 to 78.975. Needs
    via-jumper around BB_BOOT2 east end (2 vias + 4 segments) or hand-route
    in GUI.
    DRC: 6 unconnected (was 9), 0 shorts, 0 clearance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
    [power_module.kicad_pcb]
2026-05-16 pcb: close U4.2/U4.3 BAT+ trunk unconnect
    2-segment waypointed route U4.3 (75.075, 82.86) → south at X=75.075 →
    east at Y=86.24 into C28.1, F.Cu width 0.4 mm. Direct line was
    blocked by C28.2 GND pad — caught by the new route_trace
    checkObstacles default-on check (KiCAD-MCP-Server c4fe565). Two
    write-attempts total, no DRC surprises.
    NOTES updated to reflect 5 remaining unconnects (down from 6) and
    why the other baseline ones aren't trivial close-outs.
    [power_module.kicad_pcb]
2026-05-16 pcb: dedupe 332 redundant traces left by autoroute SES re-imports
    Used the new dedupe_traces tool (MCP develop f467da5 / 87db988).
    332 duplicate tracks/vias across BB_VCC, BB_HDRV1/2, BB_LDRV1/2,
    REGOUT, and many others — all exact (start, end, layer, width, net)
    matches with directionality ignored. DRC unchanged before/after
    (5 unconnects, 0 electrical errors); duplicates were redundant
    copper, removing them has no electrical effect.
    File size: 2704 lines removed.
    [power_module.kicad_pcb]
2026-05-16 notes: 2026-05-18 session — tooling sprint summary
    Six MCP commits, plus C26/J1.A9 v2 live test results, plus the
    dedupe_traces application that just dropped 332 duplicates from
    the PCB.
2026-05-16 notes: 2026-05-16 session 3 — find_via_lane v3 + C26 root cause
    Pure tooling session. Shipped Strategy F (obstacle-bbox-aware
    L-shape) in KiCAD-MCP-Server commit f79ba74. Verified on C26:
    F runs cleanly but C26 still fails — and the new diagnostic
    reveals why: via1/via2 straddle BB_BOOT2 so VHV can't help,
    and east/west HVH hits BB_FB and BB_SW1/BB_BOOT1 vias.
    Queued Strategy G (Z-shape with back-leg X sweep) as v4.
2026-05-16 pcb: BAT1 cell-pad fork-via cleanup + reroute
    Each of the 4 inner BAT1 cell pads (CELL2_TOP pads 2,3 and
    CELL1_TOP pads 4,5) had three vias attached: a pad-center via,
    a south-offset in-pad via, and a 3 mm displaced via. The first
    two existed only to graft the pad onto an In1.Cu (GND layer)
    fork — a 1.5 mm wide stub plus a multi-segment narrow jog —
    that fed the displaced via and ultimately the long B.Cu chain.
    Result: 4 fingers of CELL*_TOP copper cutting through the GND
    pour and 8 redundant vias cutting through the PWR pour, for no
    electrical benefit (the cell pads and the long routing chain
    are both on B.Cu, so no F.Cu↔B.Cu transition was ever needed).
    - Removes the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
    [power_module.kicad_pcb]
2026-05-16 notes: 2026-05-16 session 4 — BAT1 fork-via cleanup + B.Cu reroute
    Removed 12 redundant vias and 14 In1.Cu fork-traces at the BAT1
    cell pads; added 4 direct B.Cu tracks. Captured the
    SMD-pad-layer gotcha (cell holder mounts on bottom, BAT1 pads
    are B.Cu not F.Cu) in feedback memory + new task #154 for the
    MCP improvement.
2026-05-16 notes: 2026-05-16 session 5 — get_component_pads layers + CHG_OUT scout
    Shipped get_component_pads `layers` field (MCP commit 97bb047,
    task #154). Investigated CHG_OUT U3.10↔L1.2: tight QFN area
    defeats current tool set — find_via_lane's via-vs-copper
    clearance gap (now filed as task #155) would have shorted via
    to pad 11 (GND). Deferred to GUI hand-route. Baseline DRC
    preserved.
2026-05-16 notes: 2026-05-16 session 6 — find_via_lane v4 + via clearance
    Shipped task #155 (via-vs-copper clearance check, catches the
    session-5 CHG_OUT bug) and task #153 (Strategy G — 4-corner
    Z-shape, finds the right shape for C26 but can't end-to-end-
    complete it because the via still sits too close to BB_BOOT2,
    which needs Strategy H "via re-walk" — filed as #156).
2026-05-16 notes: 2026-05-16 session 7 — Strategy H + C26 structural verdict
    Strategy H shipped (clearance-aware via walk, task #156). With
    Strategy H the find_via_lane suite is now complete for the
    via-jumper use case. C26 BB_VCC formally closed as structurally
    unroutable via through-via: BB_SW1 (In1.Cu) and BB_COMP (In2.Cu)
    tracks overlap the C26.1 pad region — no via tool can fix this,
    needs layout change or hand-routed F.Cu detour.
2026-05-16 power: classify CELL_TOP into POWER_4A + min-width DRC rule
    Two related fixes for the "battery nets routed at 0.2mm because
    they weren't in a netclass" problem found in session today.
    1. .kicad_pro: add netclass_patterns entries for CELL1_TOP and
    CELL2_TOP into POWER_4A (1.5mm tracks). They carry the same 4A
    current as BAT+/BAT- through the 3-cell series stack but were
    previously falling to Default (0.2mm). Future autoroutes /
    manual routes will now pick up 1.5mm width by default.
    2. New .kicad_dru: custom DRC rules enforcing minimum track width
    per power netclass (POWER_4A ≥ 1.0mm, POWER_2A ≥ 0.5mm). The
    thresholds sit below the netclass default widths (1.5mm and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
2026-05-16 notes: 2026-05-16 session 8 — netclass + DRC width rule
    User-flagged trace widths surfaced that CELL1_TOP/CELL2_TOP were
    not in any netclass — fell to Default 0.2mm despite carrying 4A
    through the cell series stack. Shipped netclass assignment +
    custom DRC rules (POWER_4A ≥ 1.0mm, POWER_2A ≥ 0.5mm). The 8
    existing under-sized B.Cu power traces are now flagged by DRC
    but not yet widened — in-place widening collides with GND
    stitching vias and parallel routing, needs layout-level re-work.
    Also: MCP modify_trace param mismatch fix shipped.
2026-05-16 notes: restart plan for next session
    User and assistant agreed to clear the PCB and re-place + re-route
    from scratch. Schematic stays as source of truth. Plan section
    added so post-compact next-me can pick up cold and execute the
    agreed workflow without rediscovering it.
2026-05-16 pcb: clean placement restart — all 71 footprints repositioned by functional group
    Strip-and-re-place pass per the agreed restart plan in NOTES.md.
    Anchors first (BAT1 cell holder B.Cu, J1 USB-C right edge,
    J2/J3/SW1 bottom edge), then major ICs (U1 BMS, U2 PD, U3 charger,
    U4 buck-boost) + power FETs + inductors. Decoupling/bypass caps
    placed via place_near against their actual electrical targets
    (verified by pad-net lookup after one mis-assignment — C2 was
    moved off cell-sense to U3 then corrected).
    Pre-restart snapshot is at tag pre-restart-2026-05-16. User
    adjustment pass is next (placement is dense in the BMS area
    and the Q2/Q3 courtyards touch by 2.5mm² — no pad collision).
    [power_module.kicad_pcb]
2026-05-19 Moved footprints around a little
    [power_module.kicad_pcb]
2026-05-19 pcb: post-user spread pass — relieve crowding around U1 and U4
    User adjustment pass moved BAT1 up and components into a compact
    lower band; cluster-density check showed 17 components within 8mm
    of U1 (BMS) and 17 within 8mm of U4 (buck-boost), too tight to route.
    This pass:
    - Shifts U4 +6mm right (84,88) for thermal/edge clearance from
    BAT1 cell holder B.Cu pads (user-suggested in case the integrity-
    checker NPTH-via false positive was actually a ventilation concern).
    - Re-places 39 small parts via pin-targeted place_near against the
    correct U1 / U3 / U4 pad numbers, honoring the C9 → U1.9 explicit
    Placement_Anchor (the one the user noticed had missed last pass).
    -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
    [power_module.kicad_pcb]
2026-05-19 More minor shifting
    [power_module.kicad_pcb]
2026-05-19 Inspecting progress
    [power_module.kicad_pcb]
2026-05-19 pcb: north-spread BMS + charger into upper-half BAT1 envelope
    Moved U1 BMS + Q1 + R5 sense + 17 satellites to NW quadrant (y=33-45),
    moved U3 charger + L1 + R10 + Q2 + 9 satellites to NE quadrant
    (y=35-45). Buck-boost U4 cluster stays south, output stage stays south.
    The upper-half F.Cu was empty since BAT1 lives on B.Cu — used that
    real estate to relieve density.
    analyze_congestion result:
    - before: 5 cells score >= 238 (U1, U3, U4+BAT1, all ~270)
    - after: 2 cells score >= 238, both U4+BAT1 region (inherent
    buck-boost density). U1 and U3 hotspots dropped off the top-12.
    - active cells 85 -> 53, top score 272 -> 240.
    Cell-sense routing also benefits: U1.VC pins are now at x=22-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
    [power_module.kicad_pcb]
2026-05-19 Resized board and moved pieces back onto BAT1 area
    [power_module.kicad_pcb]
2026-05-19 pcb: relax_placement pass (ICs locked, satellites moved)
    Used the new relax_placement tool (KiCAD-MCP-Server develop bd9569e)
    with all major ICs / FETs / inductors / LEDs locked, allowing only
    caps + resistors to move. 200 iters, default spring/repulsion params.
    Result vs pre-relax:
    - Ratsnest length: 1369 mm → 1216 mm (-11%)
    - Ratsnest crossings (v1 metric, component-center): 60 → 51 (-15%)
    - 54 components moved (top mover R3 by 18 mm)
    - 0 pad-copper-overlap errors, 21 tiny courtyard touches
    (max 0.88 mm², all < 1 mm² — acceptable for routing)
    C8 needed a manual place_near nudge afterward (the relax v1's bbox
    repulsion didn't fully resolve its 0.022 mm² pad-touch with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
    [power_module.kicad_pcb]
2026-05-19 notes: 2026-05-19 session — placement tooling sprint summary
    Records the session's tooling shipped (analyze_congestion,
    get_ratsnest, relax_placement v1, auto-save fix), the board
    state after the relax pass (improved metrics but per user
    assessment U4/U1 areas still not routable), the 2026-05-20
    plan (unify schematic + PCB autoplacers per task #186), and
    the routing-tool gaps observed (route_trace clearance check,
    route_pad_to_pad pin escape — tasks #177, #178).
2026-05-19 Testing pcb autoplacer first pass
    [power_module_v2test.kicad_pcb]
2026-05-20 more changes
    [power_module_v2test.kicad_pcb]
2026-05-21 notes: 2026-05-20 + 2026-05-21 — autoplacer v2 unification + tuning shakedown
    Two sessions' worth of progress:
    * 2026-05-20: schematic + PCB autoplacers unified into one
    force-directed engine (task #186 done). Spring classes, OBB
    repulsion, lever-arm torque, snap potential, 4-phase schedule,
    live viz module. First real-board run had the right machinery
    but the wrong placements — pin classes for decoupling caps
    aren't yet wired up.
    * 2026-05-21: six fixes from running v2 on the actual
    power_module board + inspecting dynamics in Jupyter. Fixed
    the rotated-bbox bug, cross-layer spring flag, sign error in
    lever-arm torque, schematic torque applying noise to PCB
    pads, p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
2026-05-26 Locked U4
    [power_module.kicad_pcb]
2026-05-26 notes: 2026-05-26 — routing-prep tooling shipped (#176/#177/#178/#181)
    KiCAD-MCP-Server side: width/clearance-aware obstacle detection,
    pin-escape stubs on route_pad_to_pad, stitch_pour_vias MCP tool, and
    analyze_congestion layer filter. Plus docs sweep. All unblocking the
    power_module routing pass (#169-172).
2026-05-26 PCB: autoroute + refill_zones pass
    Post-tuning autoplacer state autoroute via freerouting with the
    GND-last layer order ([F.Cu, B.Cu, In2.Cu, In1.Cu]) — 593 tracks,
    84 vias, 149.5s. Refilled both zones (GND on In1.Cu, BAT+ on In2.Cu).
    DRC: 358 errors → 54 errors post-refill.
    Also added 6 intra-IC same-net pad bridges (0.3-0.5 mm narrow):
    U4.2/3 BAT+, U4.12/13 V12_OUT, U1.9/10 BAT+, Q3.7/8 BAT+,
    Q2.5/6 BQ_PH, Q2.7/8 USB_VBUS.
    Pending: BAT1 vias (B.Cu↔In1.Cu bridge for 10 of 20 unconnects),
    hand-fix U3/U4 remaining 10 unconnects, final DRC verify.
    [power_module.kicad_pcb]
2026-05-26 PCB: add 4 BAT1 stitch vias on west-side cell terminals
    Bridges BAT1's B.Cu pads to the In1.Cu tracks freerouting left
    floating. Closes 4 of 10 BAT1 unconnects: BAT1.1 BAT+, BAT1.3
    CELL2_TOP, BAT1.5 CELL1_TOP, BAT1.6 BAT-.
    East-side BAT1 vias (BAT1.2 CELL2_TOP, BAT1.4 CELL1_TOP) attempted
    but rolled back — the 0.6 mm vias short into nearby freerouting
    F.Cu traces at the BAT1 east-edge area. Hand-fix needed: either
    move those tracks or use a smaller via and offset the via slightly
    from pad center.
    State: 50 errors / 16 unconnected remaining.
    [power_module.kicad_pcb]
2026-05-26 notes: 2026-05-26 — first autoroute pass + stopping point
    Documents the routing pass: 6 intra-IC bridges, freerouting baseline
    (593 tracks/84 vias), refill_zones (didn't segfault), 4 BAT1 west-
    side stitch vias. Closed 162 of 182 unconnects → 16 remaining.
    Stopped at a clean handoff for hand-fixing the dense IC areas (U3,
    U4 fan-out, BAT1 east-side vias, USB_VBUS chain).
2026-05-26 Moved all the traces off GND layer, and some off PWR layer.
    [power_module.kicad_pcb]
2026-05-26 power_module.kicad_pro: re-add CELL1_TOP/CELL2_TOP to POWER_4A patterns
    These were silently dropped in commit 14a143a ("Moved footprints
    around a little") when KiCAD GUI re-saved the .kicad_pro. Without
    the pattern, CELL_TOP fell back to Default netclass (0.2 mm) instead
    of POWER_4A (1.5 mm) — every future autoroute / route_pad_to_pad
    ended up with thin traces on the 4A cell-stack connections.
    Closes one half of the BAT1-traces-too-thin issue. The other half
    (autoroute routing them on inner GND/PWR planes) is addressed in
    KiCAD-MCP-Server `develop` by the #203 plane-layer-type DSN fix.
2026-05-26 notes: 2026-05-26 — autoroute post-mortem (4 root causes diagnosed)
2026-05-26 re-route attempt: DSN plane fix verified; pre-route on B.Cu
    Three-pass re-route exercising yesterday's MCP fixes. Net change:
    Attempt #1 (clean autoroute):
    - planeLayersFlippedToPower: [In1.Cu, In2.Cu] confirmed the #203 fix
    is active. BAT+/BAT- now on F.Cu, not inner planes.
    - Trade-off discovered: with inner layers locked, freerouting
    couldn't bridge the 82mm cell-holder span and left CELL1_TOP,
    CELL2_TOP entirely unrouted (65 unconnects).
    Attempt #2 (pre-route + autoroute):
    - 4 BAT1 trunks pre-routed on B.Cu at 1.5mm POWER_4A
    (CELL1_TOP, CELL2_TOP, BAT+, BAT- starter trunks).
    - autoroute extended these into a full BAT+ F.Cu network
    through U3 and the decoupling caps. 442 track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
    [power_module.kicad_pcb]
2026-05-26 Moved U4 to bottom, away from pads and away from cells. Swapped SMD thermistor for THT and moved to B.Cu. Locked thermistor and BAT1.
    [bms.kicad_sch, buckboost.kicad_sch, charger.kicad_sch, power_module.kicad_pcb, power_module.kicad_sch]
2026-05-26 re-route with new U4 position: 0 shorts, 0 clearance
    After U4 moved south (extending the board), re-ran the routing
    pipeline: relax_placement → pre-route BAT1 trunks on B.Cu →
    autoroute. Best result of the day at this checkpoint.
    DRC: 65 errors / 106 warnings.
    - 0 shorts (the BAT1.2-in-U4-territory recurring issue is gone).
    - 0 clearance violations.
    - 9 track_width (pin-escape stubs - bridge candidates).
    - 53 unconnected (mostly GND pour-vias not added; #212 blocks).
    Discovered MCP bug #212: stitch_pour_vias places vias only along
    the zone outline boundary (skippedOutside=775), not the interior.
    Zone.HitTest matches polygon edge, not containment.
    64 of 71 components migrated s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
    [power_module.kicad_pcb]
2026-05-26 notes: stitch_pour_vias fix + dead-end of grid-only stitching
    Documented the stitch_pour_vias bug found and fixed in
    KiCAD-MCP-Server 5531c4c (#212): ZONE.HitTest was a graphical
    boundary check, not point-in-polygon. Fix uses
    SHAPE_POLY_SET.Contains() and is exercised by a new regression
    test.
    Also documented what the fix did NOT solve: applying 200 GND
    stitching vias on a 5mm grid added 181 via_dangling warnings and
    3 new shorts, while closing only 3 unconnects. Reason: grid
    stitching doesn't connect F.Cu GND pads to anything - the pads
    still need traces or pad-adjacent vias. Reverted to the prior
    574172e board state.
    Next session should try F.Cu+B.Cu GND pours OR pad-adjacent vias.
2026-05-26 apply via_orphan_pads + widen_return_paths: -15 DRC errors
    via_orphan_pads added vias adjacent to:
    - 26 orphan F.Cu GND pads (skipped 30 already connected, 6 no
    clearance). Notable: 3 vias on U4 pin 29 (LM5176 thermal pad).
    - 2 orphan F.Cu BAT+ pads (C9.1, C8.1).
    widen_return_paths widened 25 segments to 1.5 mm (POWER_4A width)
    across 23 high-current components. 37 segments blocked by clearance
    in the U4/U3/U1 thermal pad areas - those were skipped, no shorts
    introduced.
    Net: 65 -> 50 errors. Unconnects 51 -> 34 (17 closed). Still 0 shorts
    and 0 clearance violations. 2 new tracks_crossing and 6 hole_to_hole
    to clean up next pass.
    [power_module.kicad_pcb]
2026-05-26 apply via_orphan_pads v3 + widen_return_paths: 65 -> 38 DRC errors
    Re-applied the routing-finisher pipeline from the 574172e baseline
    with the v2 + v3 toolchain:
    via_orphan_pads v3 (orphan-chain detection + PTH/thermal-via skip
    + netclass-aware stub widths + stub-trace clearance check):
    - GND: 35 vias placed (skipped 4 already connected,
    8 no clearance — stub or via).
    - BAT+: 9 vias.
    - V12_OUT: 3 vias.
    widen_return_paths: 19 GND/return stubs widened to 1.5 mm.
    DRC: 65 -> 38 errors. Headline:
    - 0 shorts (vs v2's 8 - stub clearance v3 prevented every short).
    - 24-26 unconnects closed.
    - 11 track_width (mostly USB_VBUS pin-escape stubs, candidate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
    [power_module.kicad_pcb]
2026-05-26 notes: via_orphan_pads v3 + pin_zone_same_net + bonus fixes; board 65->38
2026-05-26 apply pin_zone_same_net v3: 17 paired-pin zones, 7 correctly rejected
    After fixing the 2-pad opposite-corner pathology (absoluteMaxDistMm,
    #218) and adding foreign-pad-overlap rejection (#219), applied
    pin_zone_same_net to the current board. 17 zones placed across
    Q1-Q4 dual-FETs, U1/U4 paired pins, J1 shell pads, and the U4
    thermal pad on B.Cu.
    The 7 rejected zones include exactly the cases the user warned
    about: pads at opposite ends of an IC body with foreign-net pads
    between them (U2 USB_VBUS 1+8, U3 GND 11+17, U4 F.Cu GND across the
    package, J1 USB-C pin pairs with CC/NC pads between).
    DRC unchanged at 38 errors. The track_width violations remain
    because the original thin pre-route st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
    [power_module.kicad_pcb]
2026-05-27 close BAT- east-end unconnect (#210)
    Bridges F.Cu BMS island to existing B.Cu east trunk via top-of-board
    corridor: F.Cu vertical at x=20.12 (38.93->8) + via + B.Cu horizontal
    at y=8 (20.12->60) + B.Cu short south to existing trunk end (60,12.45).
    26 -> 25 unconnects; refill_zones cleared new inner-plane via clearance
    flags. DRC: 149 -> 147 violations.
    [power_module.kicad_pcb]
2026-05-27 add 4 BAT+ via stubs to bridge orphan F.Cu islands to In2.Cu plane (#169)
    Vias at (71.62,63.90) C8.1, (70.79,53.48), (36.77,50.08), (72.52,39.81)
    — closes 1 BAT+ ratsnest gap. The rest of the BAT+ unconnects need
    trace re-routing (C8↔C28 area is congested with U4 BB_* signals;
    SW1.2 and U3.9 need pin-escape stubs that conflict with adjacent
    nets).
    DRC: 147 -> 146 violations; 25 -> 24 unconnects; no new shorts or
    dangling traces.
    [power_module.kicad_pcb]
2026-05-27 fix U4 GND thermal-pad bond + clean up redundant GND vias (#221)
    - Add via at U4 pin 22 (67.564, 69.893) to bond it to the In1.Cu GND
    plane. Pin 22 was a F.Cu-only SMD pad isolated from U4's thermal
    pad island because the F.Cu GND zone had a void around the IC body.
    Closes the U4.22 <-> U4.29 ratsnest gap.
    - Delete stacked GND via at (65.158699, 19.7992) — was 0.5mm from
    the (65.158699, 19.2992) via (hole_to_hole error).
    - Delete redundant GND via at (63.4765, 67.943) — overlapped U4's
    own thermal-pad PTH via at (63.5765, 67.818) (hole_to_hole error).
    - Delete the now-orphan GND L-bend stubs that were leading to the
    removed vias.
    DRC: 145 -> 142 violations; 36 -> 35 errors;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
    [power_module.kicad_pcb]
2026-05-27 Working on fixing unconnects etc
    [power_module.kicad_pcb]
2026-05-27 dedupe: remove 201 exact-duplicate tracks left by autoroute re-imports
    Result of running dedupe_traces(apply=true) on the board. The duplicates
    were accumulated over the stop-and-go routing sessions where autoroute /
    import_ses ran more than once — pcbnew.ImportSpecctraSES appends rather
    than replaces, so each rerun left a clone of every routed segment on
    top of the previous one.
    KiCAD-MCP-Server commit ce7a3a2 now calls dedupe_traces automatically
    at the end of autoroute and import_ses, so this kind of accumulation
    won't happen again in future sessions.
    DRC: doubled-trace-induced noise cleared. Down from ~250 to 34 total
    violations (28 errors, 6 warnings); much closer to a real picture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
    [power_module.kicad_pcb]
2026-05-27 add Schematic_Metadata singleton (META1) with mcp_constraint_version=2
    First use of the singleton convention from KiCAD-MCP-Server #230.
    META1 is a DNP symbol (in_bom no, on_board no) carrying the
    project's MCP metadata as properties readable from eeschema's
    symbol-properties dialog. Open the schematic in eeschema, select
    META1 (top-left of the sheet), and you'll see the metadata fields
    alongside Reference/Value.
    Currently just the version marker; per-pad Pin_Spring_Class tags
    on bypass caps (C29/C30/C3/C4) are next per the workflow doc.
    [power_module.kicad_sch]
2026-05-27 annotate bypass caps with Pin_Spring_Class:1 = DECOUPLING
    C3, C4 (bms.kicad_sch) and C29, C30 (buckboost.kicad_sch) are
    bypass / decoupling caps that need to sit right next to their IC
    pin during placement. With this annotation the auto-placer
    (relax_placement) parks them at <1 mm from the target IC pin
    instead of leaving them at the default 5+ mm.
    Reads at session-load time per #228, so no PCB-side sync needed.
    [bms.kicad_sch, buckboost.kicad_sch]
2026-05-28 charger: per-target spring annotations + selective autoplace of U3 group
    Annotate U3's decoupling/bulk/bootstrap caps with per-target
    Pin_Spring_Class ({"U3.N": "DECOUPLING"}) so each is pulled onto the
    specific pin it serves rather than everything on its rail; status LED
    D1 weakly tethered (INTER_GROUP). Classify USB_VBUS as INTER_GROUP in
    the META1 spring-class net map (cross-group rail; stops Q2 drifting to
    the input side). Selectively relax the charger satellites with U3
    anchored and all other groups locked.
    [charger.kicad_sch, power_module.kicad_pcb, power_module.kicad_sch]
2026-05-28 charger: incremental autoroute of 6/8 BQ signal nets
    First use of the new incremental autoroute (MCP #242): routed
    BQ_PH/BQ_VREF/BQ_VFB/BQ_BTST/BQ_LODRV/CHG_OUT (+69 tracks, +5 vias),
    leaving all non-charger copper byte-identical. refill_zones run after.
    Hand-off state for review: BQ_HIDRV and BQ_STAT1 still open, and ~8
    clashes remain where the freshly-routed charger tracks meet the existing
    USB_VBUS pour / fixed pads (the incremental-route caveat — freerouting
    optimized against a re-routed scratch layout). DRC 108 total.
    (.kicad_sch: verify_netclass_patterns bootstrapped the
    mcp_expected_netclass_patterns metadata property — purely additive.)
    [power_module.kicad_pcb, power_module.kicad_sch]
2026-05-28 Claude did some re-placing
    [power_module.kicad_pcb]
2026-05-29 charger: re-place + re-route with new autoplacer (intent-group, cluster=50)
    Re-ran the charger strip/autoplace/autoroute on the upgraded autoplacer
    (MCP #248/#249/#250). Placement win: C16 now sits 2.4mm from U3.1 with
    its hot pad facing U3 (was 5.2mm facing away) — intent-group normalization
    validated on the real board. Routed 5/10 charger nets (BQ_PH/REGN/VFB/
    VREF/CHG_OUT) in 17.7s, no timeout (the strip-before-export fix). 5 hard
    nets still open (Q2 gate drives + BQ_TS). DRC 101 — mostly stale
    shared-rail (USB_VBUS/GND/BAT+) charger stubs from the re-placement +
    unconnects on the open/stripped nets; see NOTES.md "RESUME HERE".
    Tomorrow: build the shared-net stub auto-cleaner (task #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
    [power_module.kicad_pcb]
2026-05-29 charger: scrub_region cleanup + incremental re-route (shorts 11 -> 0)
    Used the new scrub_region tool to clear the charger's stale shorting copper
    (the USB_VBUS wrap + BAT+/CHG_OUT mess around U3), then re-routed:
    - scrub_region(U3,L1,Q2,C10,C12-16,R10-14,D1): -55 tracks/-9 vias/-2 zones;
    every one of the 11 shorts + 6 dangling tracks was in the kill-list.
    - 2 incremental autoroute passes closed 11/12 charger-private nets
    (incl. CHG_OUT->L1 and BQ_PH); via_orphan_pads added 15 GND plane vias.
    - DRC: 11 shorts -> 0, 0 dangling, 18 unconnected (~14 tight QFN/cluster
    opens left for GUI hand-route, 4 pre-existing out-of-region).
    BAT+/USB_VBUS trunks deliberately preserved (excluded from aut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
    [power_module.kicad_pcb]
2026-05-30 charger: surgical pass — 8 routes closed, 1 known-bad BAT+ detour
    Per-link route_pad_to_pad / find_via_lane closures for the remaining
    charger opens. Successes (8): BQ_TS R12.1->R11.2; BAT+ R10.2->C15.1
    (B.Cu jumper under C13), R10.2->trunk stub, U3.9->C15.1; GND U3.11->U3.17
    (EP); USB_VBUS Q2.7-Q2.8, C16.1->U3.1, Q2.8->C10.1 (B.Cu jumper).
    Known-bad route still on board: BAT+ R14.1->C15.1. find_via_lane took a
    47 mm B.Cu detour through the BMS area after I relaxed minClearance to
    dodge a 7 um-too-close GND via — accounts for ~25 of the current clearance
    errors. To be removed in the next commit; left here for inspection.
    Also deleted: USB_VBUS Q2.7->trunk via-jumper that shorted to BAT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
    [power_module.kicad_pcb]
2026-05-30 charger: remove the bad BAT+ R14->C15 detour
    Deleted the 47 mm B.Cu detour through the BMS area (4 tracks + 2 vias on
    BAT+, plus the 2 F.Cu stubs at R14.1 escape and the C15.1 landing).
    find_via_lane produced this when I relaxed minClearance to 0.13 mm to
    dodge a GND via — it found a clean-enough geometric path that happened to
    make a full lap of the board. Lesson: relaxing minClearance shouldn't be
    combined with find_via_lane's broader-search strategies without a length
    budget. R14.1 -> C15.1 is back to open for the GUI hand-route (~6 mm
    direct shot).
    DRC: 0 shorts; 10 unconnected (was 9 with the detour). Clearance/hole
    counts down ~5 from the detour state — remaining clearance issues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
    [power_module.kicad_pcb]
2026-05-31 charger: NOTES resume block — surgical-pass results
    8/18 charger opens closed by per-link route_pad_to_pad / find_via_lane,
    ~10 remain for GUI hand-route (QFN-internal escapes + the C16-boxed-in-by-
    GND USB_VBUS cluster bridge). Two find_via_lane bugs filed in
    mcp_server_issues memory: silent via-layer short on the via_jumper
    strategy, and pathological multi-cm detours when minClearance is relaxed.
    Tomorrow: MCP backlog (#194 lever-arm torque to schematic autoplacer,
    #238 stale-test cleanup, #239 platform_helper failures, the two
    find_via_lane bugs) before starting the topology-tools build.
2026-06-16 charger: second automated pass + refill cleanup (10→8 opens, 92→42 DRC)
    Used the topology-tools-enriched MCP suite for a second automated
    finishing pass. Net DRC: 92 → 42 violations. Closures:
    - R14 BAT+ plane: via_orphan_pads dropped a stitching via at
    (42.49, 3.75) F.Cu↔B.Cu, landing R14.1 on the In2.Cu BAT+ plane.
    One call — the prior surgical pass had missed this.
    - BQ_VREF complete net: autoroute(nets=["BQ_VREF"]) placed 14 tracks
    + 2 vias and closed every BQ_VREF open cleanly.
    The bigger DRC win was refill_zones absorbing 24 plane-via clearance
    + 24 hole_clearance violations that the prior session had left dirty.
    8 opens remain (same shape as 5/31 hand-off): U3.4 BQ_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
    [power_module.kicad_pcb]
2026-06-16 Connected things up - aside from trace width stuff we're deferring, drc seems fine
    [bms.kicad_sch, buckboost.kicad_sch, charger.kicad_sch, power_module.kicad_pcb, power_module.kicad_sch]
2026-06-16 NOTES: close v1, add v2 backlog from EMC + SPICE pass
    EMC pre-compliance run (kicad-happy, fcc-class-b, risk 49/100)
    surfaced three carry-over items for next rev: USB-C J1 ESD+ferrite
    missing, B.Cu coplanar GND pour + dense stitching vias to fix the
    22 RP-001 hits, GND<->PWR caps at signal vias on switching nets.
    SPICE confirmed FB divider math, current sense, BMS balance,
    decoupling impedance — kept as a regression baseline.
